LeeHudsonDLS/laserPuckPointer/documentation/parts/RS_Order.txt

7813058,6
7154081,3
6227841,3
8624146,15
5338209,9
7152808,10
7020688,5
8309948,9
4801071,3
3617689,5
3617667,5
6812950,10
