LeeHudsonDLS/laserPuckPointer/documentation/parts/partsList.xls

Description | Supplier | Part No | QTY | Cost | Total Cost
Parallax Servo Motor | RS | 781-3058 | 2 | £7.12 | £14.24
Arduino Uno | RS | 715-4081 | 1 | £11.52 | £11.52
Maxim MAX232ACPE+ | RS | 622-7841 | 1 | £3.35 | £3.35
100nf electrolytic capacitor | RS | 862-4146 | 6 | £0.46 | £2.76
LM317 voltage regulator | RS | 533-8209 | 3 | £0.87 | £2.60
1uf electrolytic capacitor | RS | 715-2808 | 3 | £0.65 | £1.95
 |  |  |  |  | £0.00
Arduino Interface PCB | Beta-layout |  | 1 | £24.00 | £24.00
DIL16 socket for MAX232 | RS | 702-0688 | 1 | £0.72 | £0.72
0.1uf ceramic capacitor | RS | 538-1310 | 3 | £0.12 | £0.35
Mosfet | RS | 480-1071 | 1 | £1.92 | £1.92
DIL4 socket for mosfet | RS | 702-0644 | 1 | £0.23 | £0.23
Laser module | Maplins | LE07H | 1 | £12.99 | £12.99
4 Way Terminals | RS | 361-7689 | 1 | £0.57 | £0.57
2 Way Terminals | RS | 3617667 | 1 | £0.28 | £0.28
10 way Headers | RS | 6812950 | 2 | £0.35 | £0.70
 |  |  |  |  | £0.00
 |  |  |  |  | £0.00
 |  |  |  |  | £0.00
 |  |  |  |  | £0.00
 |  |  |  |  | £0.00
 |  |  |  |  | £0.00
 |  |  |  |  | £0.00
 |  |  |  |  | £0.00
 |  |  |  | TOTAL: | £78.18
