LeeHudsonDLS/laserPuckPointer/documentation/models/stl/MidBracket.stl

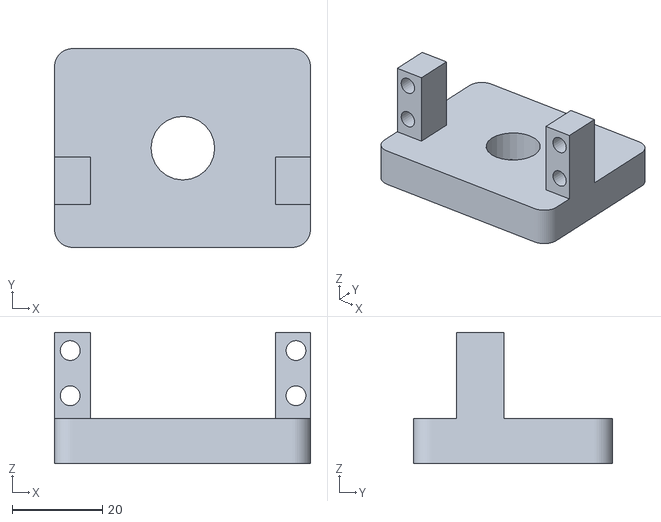
[picture p1: CAD file, 2017-01-11]
documentation/models/stl/MidBracket.stl
56.7 x 44.0 x 29.0
