LeeHudsonDLS/laserPuckPointer/documentation/models/stl/Base.stl

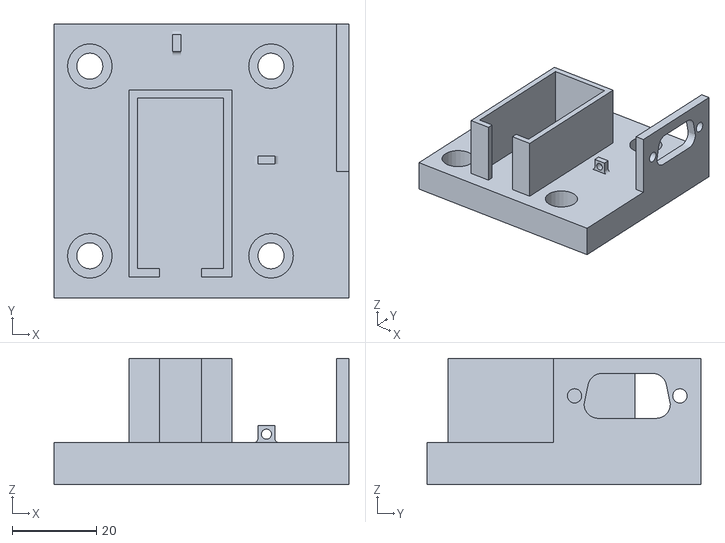
[picture p2: CAD file, 2017-01-11]
documentation/models/stl/Base.stl
70.0 x 65.0 x 30.0
