LeeHudsonDLS/laserPuckPointer/documentation/models/stl/laserHolder.stl

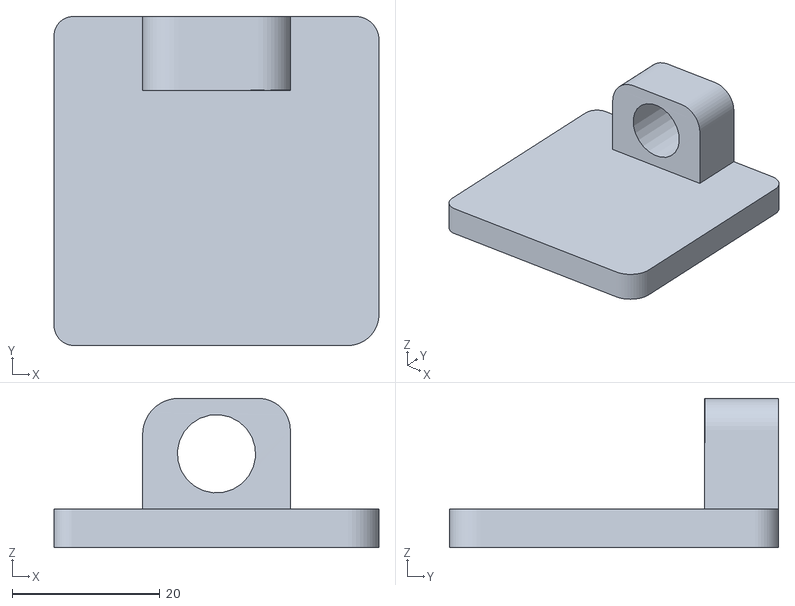
[picture p3: CAD file, 2017-01-11]
documentation/models/stl/laserHolder.stl
44.0 x 44.6 x 20.2
