LeeHudsonDLS/laserPuckPointer/(list of files, cad)

Other CAD files:
documentation/models/Base.skp
documentation/models/MidBracket.skp
documentation/models/laserHolder.skp
