LeeHudsonDLS/laserPuckPointer/documentation/Schematic.pdf

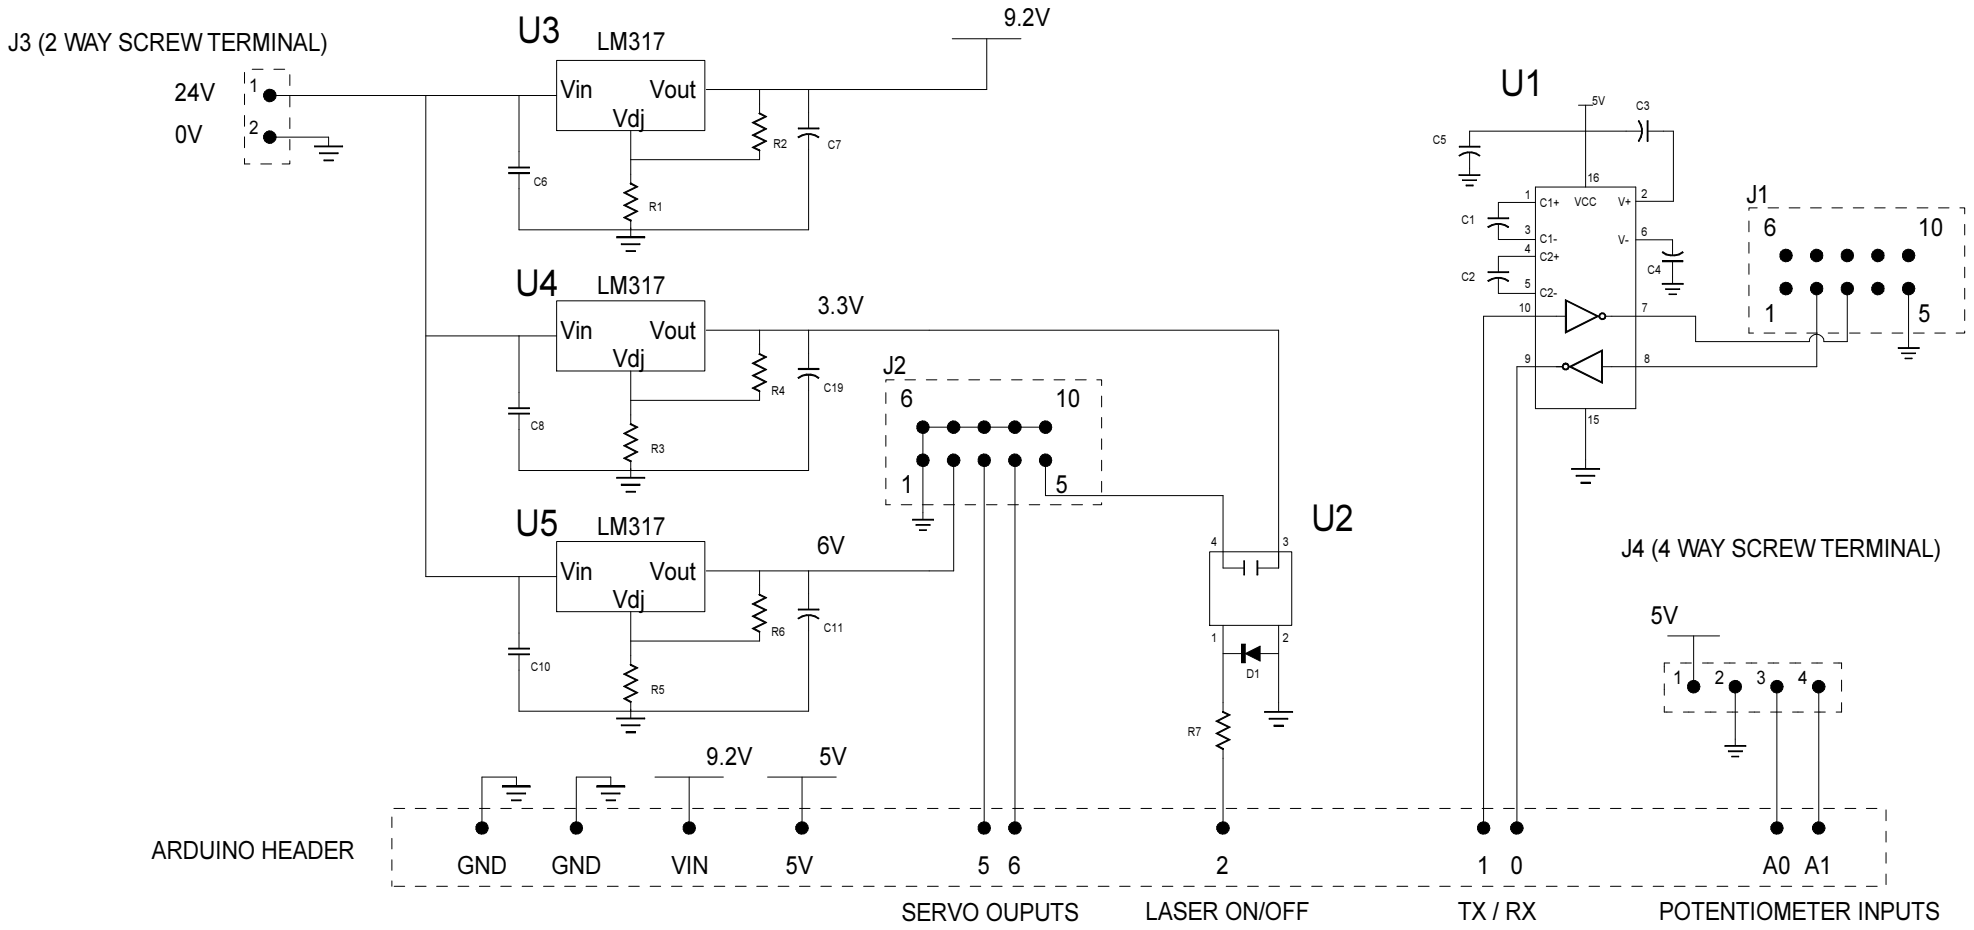
[picture p4: page 1]
