LeeHudsonDLS/laserPuckPointer/(commit log)

2016-11-03 Initial structure of new laserPuckPointer
2016-11-03 laserPuckPointer: changed contact and set svn:ignore
2016-11-17 Laser timer added
2017-03-07 Laser pin changed
2018-06-14 Credentials now stored locally until common file is readable
    [ispyb.cfg]
2019-07-02 Call to assignPucks.py now done with an & to prevent blocking
    [iSpyBWrite.c]
2019-08-08 New version of streamDevice. Laser on off corrections
